PhongTPham/WWU-VNA/(threads)

Thread 3 (2019-06-12):

Choosing correct differential pin pairings for PCB hardware

PhongTPham, 2019-06-12:
For the next PCB iteration correct differential pin pairings should be chosen to avoid hand soldering a jumper from a cut trace.

i.e. A0 and A1, A2 and A3, A4 and A5 etc etc
