PhongTPham/WWU-VNA/KiCad Schematics/2019 PHAM Modified VNA V3.kicad_pcb

## KiCad design KiCad Schematics/2019 PHAM Modified VNA V3.kicad_pcb (2019-06-03)

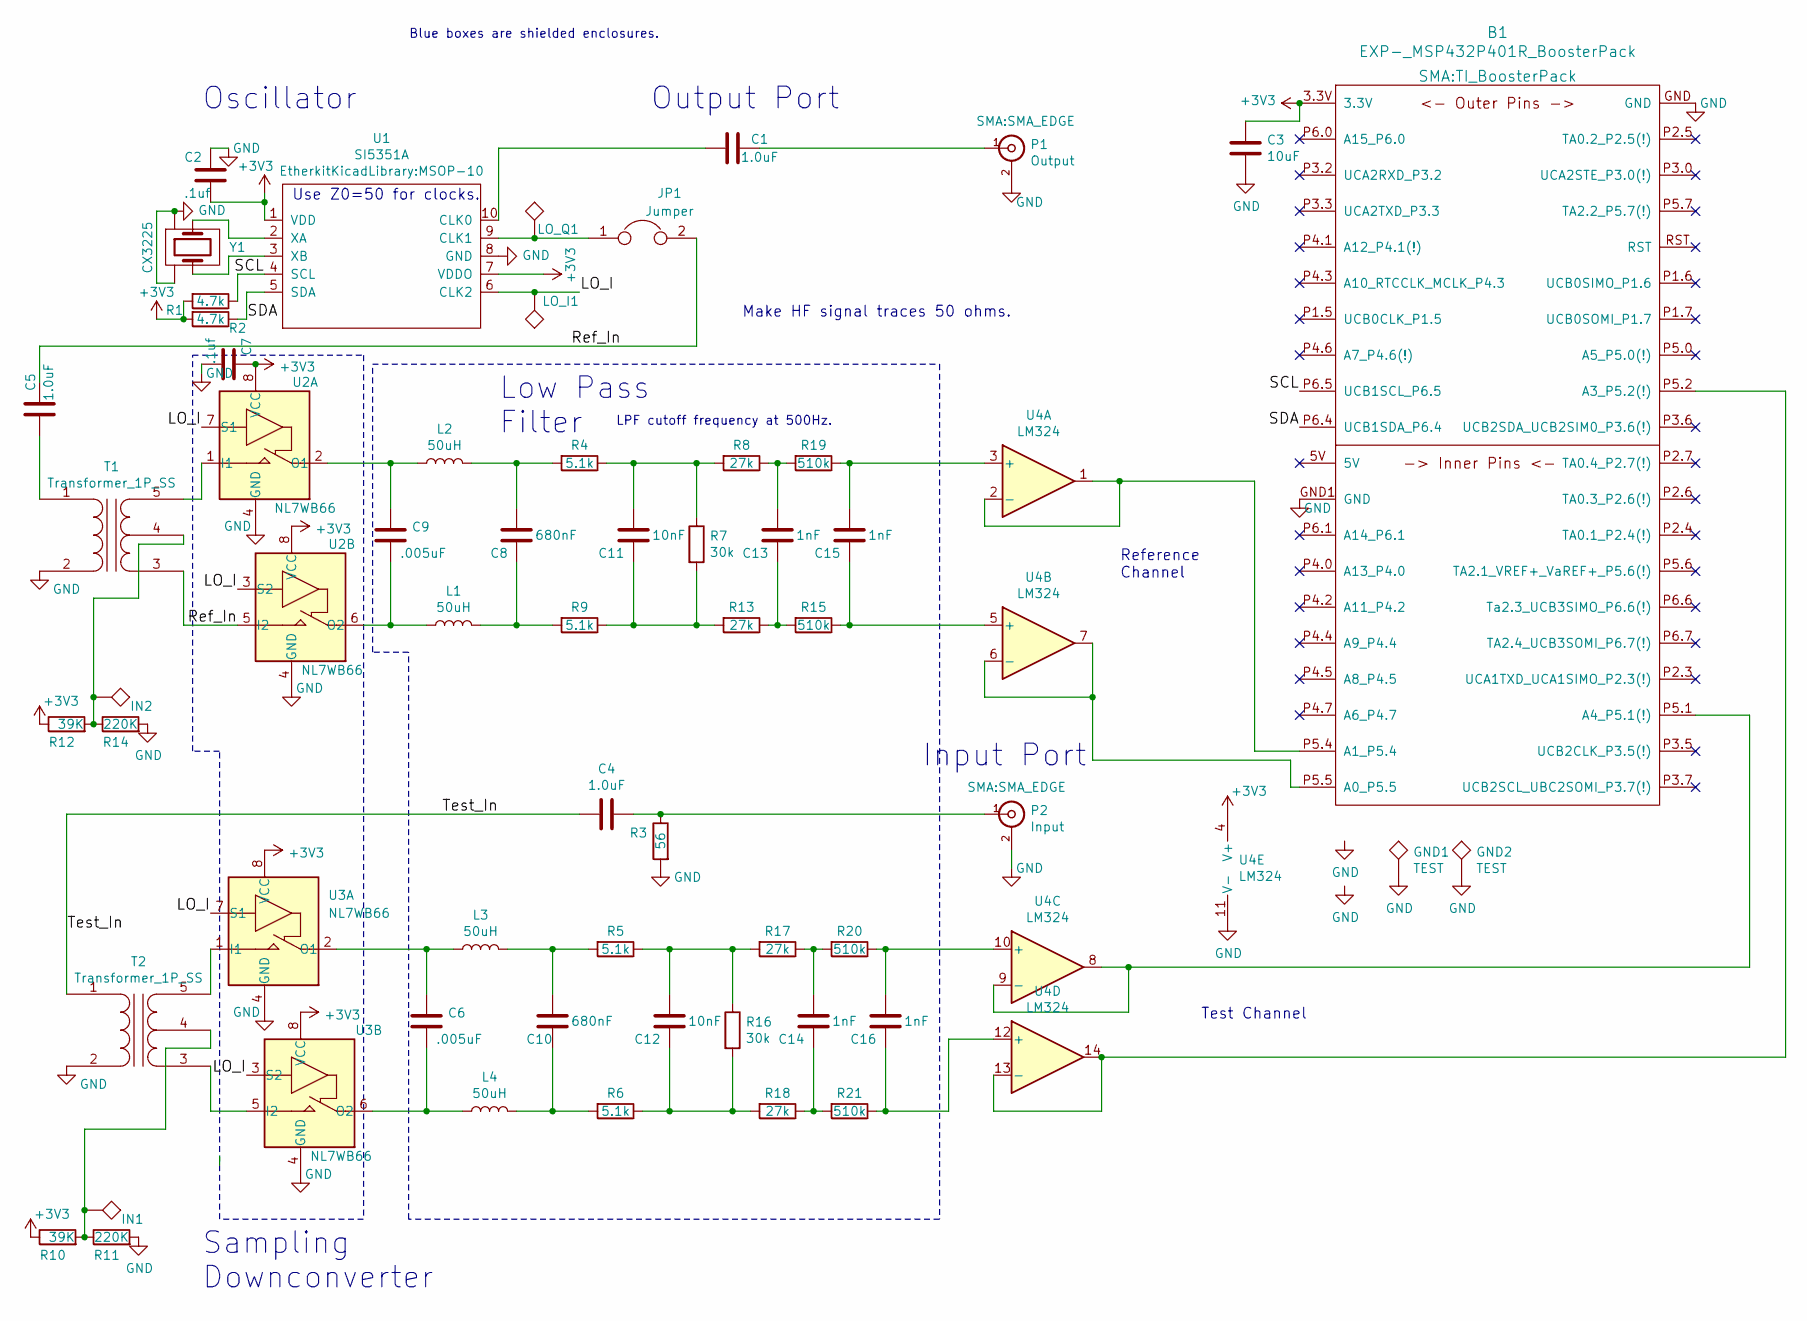
[picture p1: schematic 2019 PHAM Modified VNA V3.sch, 2019 Vector Network Analyzer BoosterPack]

Parts:
B1: EXP-_MSP432P401R_BoosterPack; TI_BoosterPack
C1, C4, C5: 1.0uF; C_0805
C2, C7: .1uf; C_0805
C3: 10uF; C_0805
C6, C9: .005uF; C_0805
C8, C10: 680nF; C_0805
C11, C12: 10nF; C_0805
C13, C14, C15, C16: 1nF; C_0805
GND1, GND2: TEST; TestPoint_Keystone_5000-5004_Miniature
IN1, IN2: IN; TestPoint_Keystone_5000-5004_Miniature
JP1: Jumper; SolderJumper-2_P1.3mm_Bridged2Bar_Pad1.0x1.5mm
L1, L2, L3, L4: 50uH; L_0805_2012Metric; Part Taiyo Yuden LB2012T101K
LO_I1: LO_I; TestPoint_Keystone_5000-5004_Miniature
LO_Q1: LO_Q; TestPoint_Keystone_5000-5004_Miniature
P1: Output; SMA_EDGE
P2: Input; SMA_EDGE
R1, R2: 4.7k; R_0805
R3: 56; R_0805
R4, R5, R6, R9: 5.1k; R_0805
R7, R16: 30k; R_0805
R8, R13, R17, R18: 27k; R_0805
R10, R12: 39K; R_0805
R11, R14: 220K; R_0805
R15, R19, R20, R21: 510k; R_0805
T1, T2: Transformer_1P_SS; Pulse_P0926NL
U1: SI5351A; MSOP-10
U2, U3: NL7WB66; VFSOP-8
U4: LM324; SOIC-14_3.9x8.7mm_P1.27mm
Y1: CX3225

Connections:
+3V3: B1.3.3V, C2.2, C3.1, C7.1, R1.2, R2.2, R10.1, R12.1, U1.1 (VDD), U1.7 (VDDO), U2.8 (VCC), U3.8 (VCC), U4.4 (V+)
/LO_I: LO_I1.1, U1.6 (CLK2), U2.3 (S2), U2.7 (S1), U3.3 (S2), U3.7 (S1)
/Ref_In: C5.1, JP1.2, T1.3 (SA), U2.5 (I2)
/SCL: B1.P6.5 (UCB1SCL_P6.5), R1.1, U1.4 (SCL)
/SDA: B1.P6.4 (UCB1SDA_P6.4), R2.1, U1.5 (SDA)
/Test_In: C4.1, T2.1 (AA)
GND: B1.GND, B1.GND1 (GND), C2.1, C3.2, C7.2, GND1.1, GND2.1, P1.2 (Ext), P2.2 (Ext), R3.2, R11.2, R14.2, T1.2 (AB), T2.2 (AB), U1.8 (GND), U2.4 (GND), U3.4 (GND), U4.11 (V-), Y1.2 (GND), Y1.4 (GND)
unnamed: B1.P5.1 (A4_P5.1(!)), U4.8, U4.9 (-)
unnamed: B1.P5.2 (A3_P5.2(!)), U4.13 (-), U4.14
unnamed: B1.P5.4 (A1_P5.4), U4.1, U4.2 (-)
unnamed: B1.P5.5 (A0_P5.5), U4.6 (-), U4.7
unnamed: C1.1, P1.1 (In)
unnamed: C1.2, U1.10 (CLK0)
unnamed: C4.2, P2.1 (In), R3.1
unnamed: C5.2, T1.1 (AA)
unnamed: C6.1, L3.1, U3.2 (O1)
unnamed: C6.2, L4.1, U3.6 (O2)
unnamed: C8.1, L2.2, R4.2
unnamed: C8.2, L1.2, R9.2
unnamed: C9.1, L2.1, U2.2 (O1)
unnamed: C9.2, L1.1, U2.6 (O2)
unnamed: C10.1, L3.2, R5.2
unnamed: C10.2, L4.2, R6.2
unnamed: C11.1, R4.1, R7.1, R8.2
unnamed: C11.2, R7.2, R9.1, R13.2
unnamed: C12.1, R5.1, R16.1, R17.2
unnamed: C12.2, R6.1, R16.2, R18.2
unnamed: C13.1, R8.1, R19.2
unnamed: C13.2, R13.1, R15.2
unnamed: C14.1, R17.1, R20.2
unnamed: C14.2, R18.1, R21.2
unnamed: C15.1, R19.1, U4.3 (+)
unnamed: C15.2, R15.1, U4.5 (+)
unnamed: C16.1, R20.1, U4.10 (+)
unnamed: C16.2, R21.1, U4.12 (+)
unnamed: IN1.1, R10.2, R11.1, T2.4 (SC)
unnamed: IN2.1, R12.2, R14.1, T1.4 (SC)
unnamed: JP1.1, LO_Q1.1, U1.9 (CLK1)
unnamed: T1.5 (SB), U2.1 (I1)
unnamed: T2.3 (SA), U3.5 (I2)
unnamed: T2.5 (SB), U3.1 (I1)
unnamed: U1.2 (XA), Y1.1
unnamed: U1.3 (XB), Y1.3 (2)

Notes on the sheet:
Use Z0=50 for clocks.
Test Channel
Reference Channel
Make HF signal traces 50 ohms.
Output Port
Oscillator
Blue boxes are shielded enclosures.
Low Pass Filter
Sampling Downconverter
LPF cutoff frequency at 500Hz.
Input Port

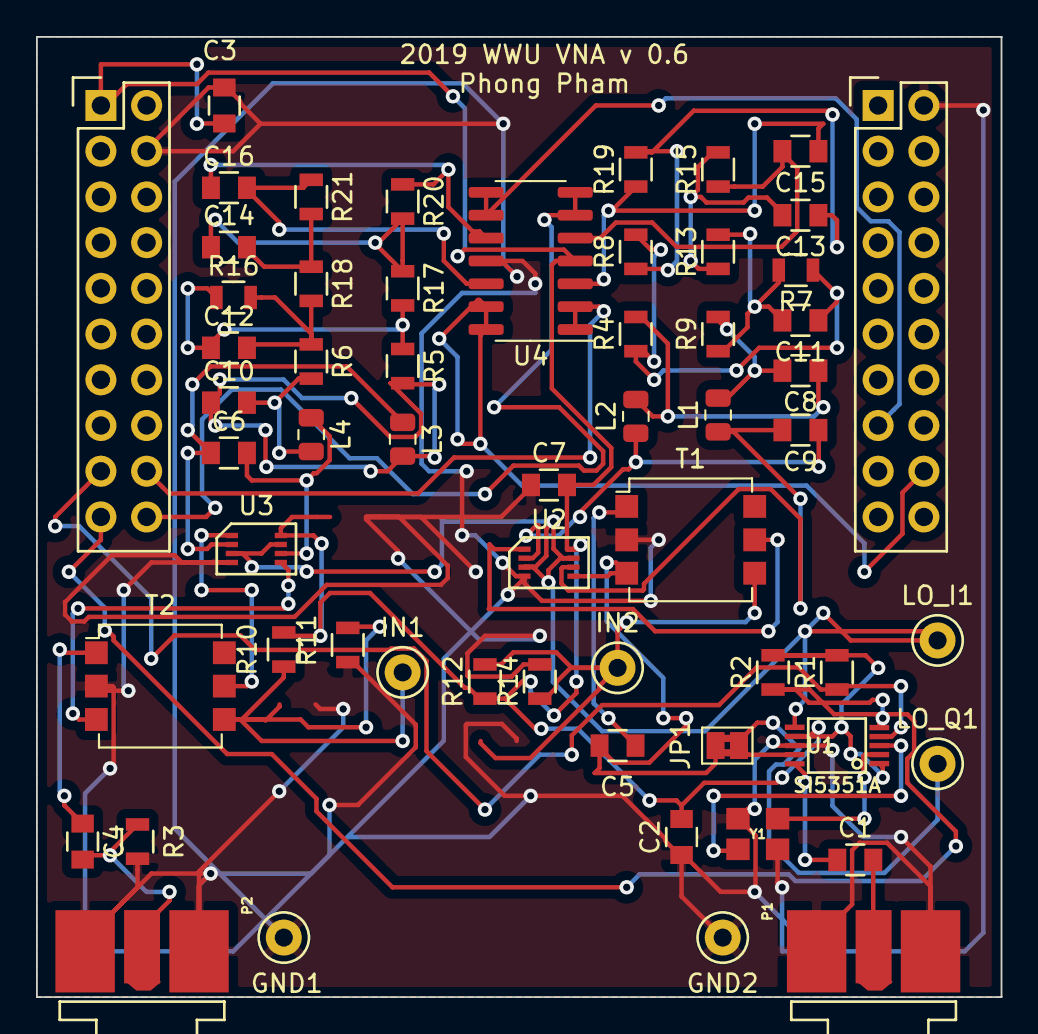
[picture p2: board 2019 PHAM Modified VNA V3.kicad_pcb from above]

Board: 2 copper layers, 53.6 x 53.3 mm, 58 parts (0 on the bottom side), 43 nets.
