PhongTPham/WWU-VNA/ADC14vna/adc14vna.h

/*
 * adc14.h
 *
 *  Created on: May 2, 2017
 *      Author: frohro
 */

#ifndef ADC14VNA_H_
#define ADC14VNA_H_
#include <ti/sysbios/family/arm/m3/Hwi.h>

/* DriverLib Includes */
#include <driverlib.h>
#include "msp.h"

#define SMCLK_FREQUENCY     12000000

/* Statics */
static volatile float adcResult;
static float convertToFloat(uint16_t result);

int adc14_main(void);
void startConversion(void);
void ADC14_IRQHandler(void);
void DMA_INT1_IRQHandler(void);
void DMA_INT2_IRQHandler(void);
//static float convertToFloat(uint16_t result);

#endif /* ADC14VNA_H_ */
