PhongTPham/WWU-VNA/(commit log)

2019-06-03 KICAD Files for Differential VNA
    PCB, Schematic and BOM for differential VNA
    [2019 PHAM Modified VNA V3.kicad_pcb, 2019 PHAM Modified VNA V3.sch]
2019-06-12 Adding CLK1 to oscillator code
    [wwu_vna.ino]
